JutomDev/MiCam/3d_print_files/front_multicolor_stl/Logo_M_bot.stl

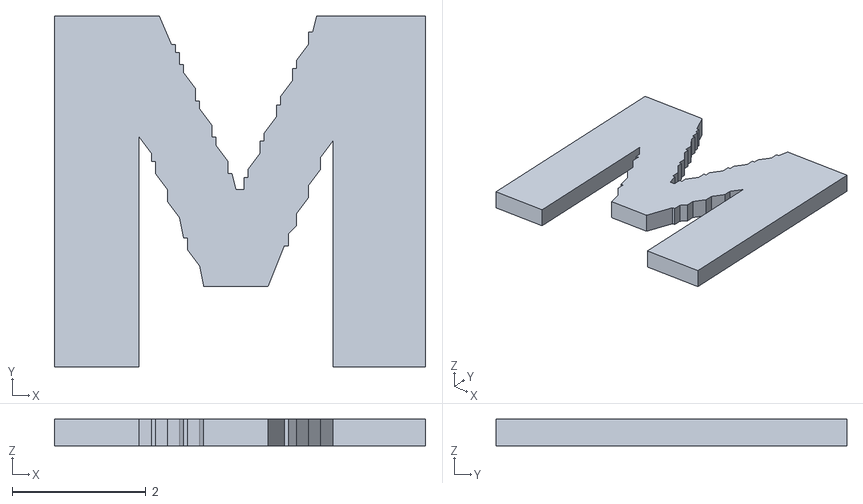
[picture p5: CAD file, 2026-10-22]
3d_print_files/front_multicolor_stl/Logo_M_bot.stl
5.54 x 5.24 x 0.4
