JutomDev/MiCam/3d_print_files/PART_Shell_Front_V8.step

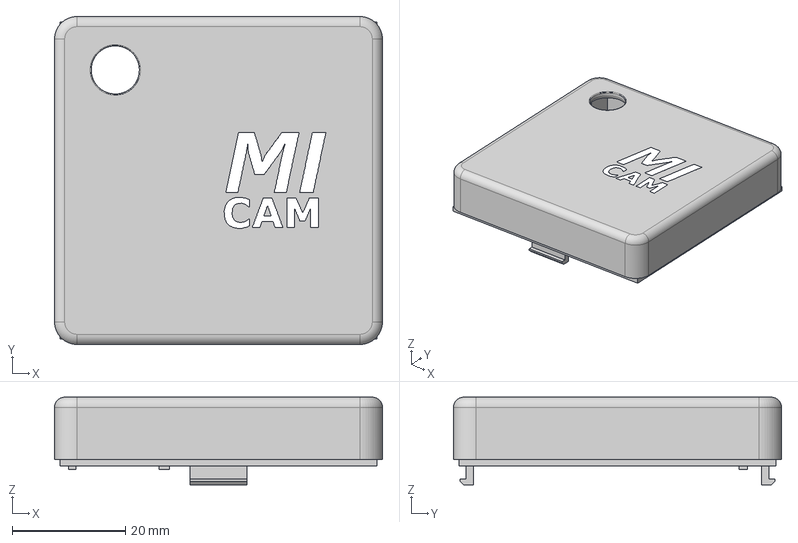
[picture p6: CAD file, 2026-10-22]
3d_print_files/PART_Shell_Front_V8.step
58.0 x 58.0 x 15.5 mm
