JutomDev/MiCam/3d_print_files/front_multicolor_stl/Logo_C_bot.stl

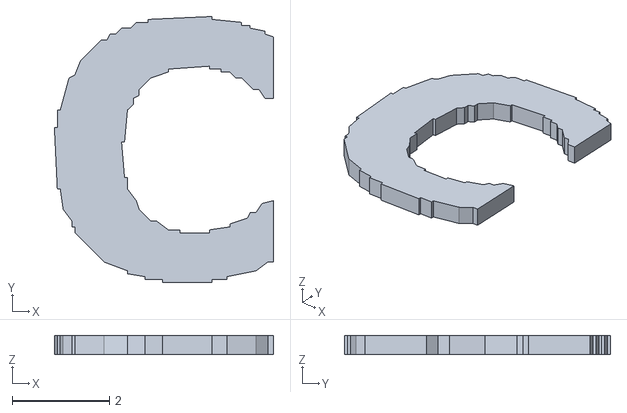
[picture p8: CAD file, 2026-10-22]
3d_print_files/front_multicolor_stl/Logo_C_bot.stl
4.51 x 5.48 x 0.4
