JutomDev/MiCam/3d_print_files/Shutter_Plunger_Button.stl

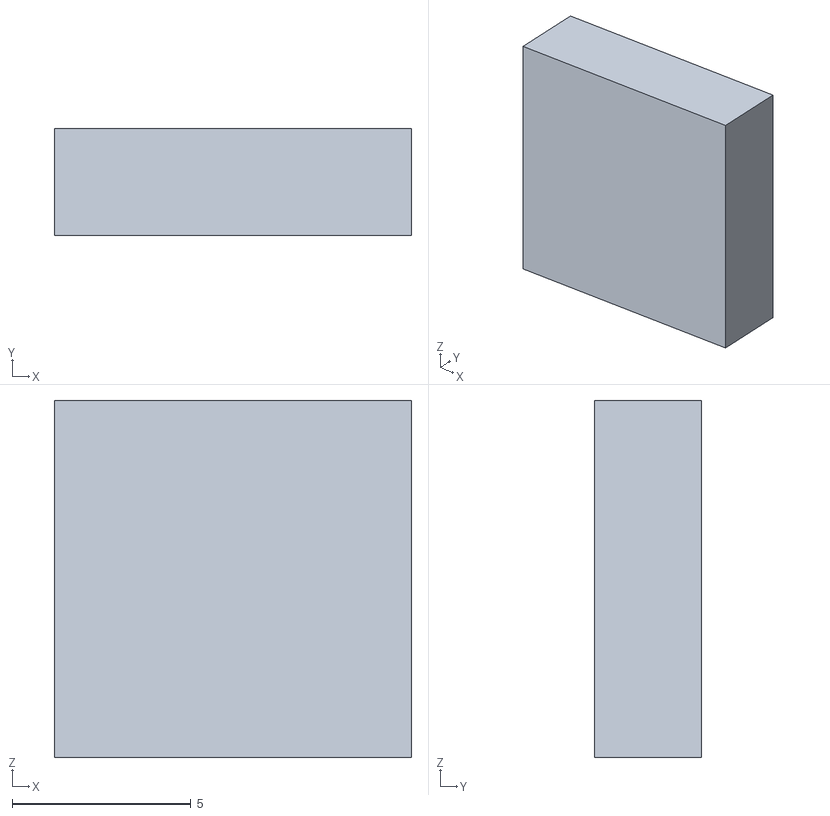
[picture p9: CAD file, 2026-10-22]
3d_print_files/Shutter_Plunger_Button.stl
10.0 x 3.00 x 10.0
