JutomDev/MiCam/cad_models/Waveshare_1.69_LCD_Module.step

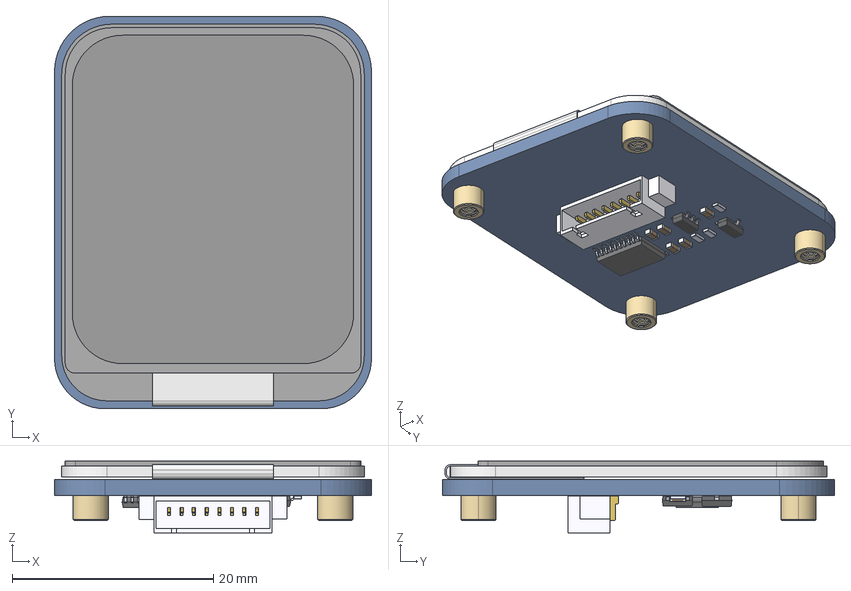
[picture p10: CAD file, 2026-10-22]
cad_models/Waveshare_1.69_LCD_Module.step
31.5 x 39.0 x 7.11 mm
1_69INCH-240X280-LCD
1_69INCH_LCD_MODULE-PCBA
STUDS-M2XH2_5 x 4
