JutomDev/MiCam/3d_print_files/front_multicolor_stl/Logo_A_bot.stl

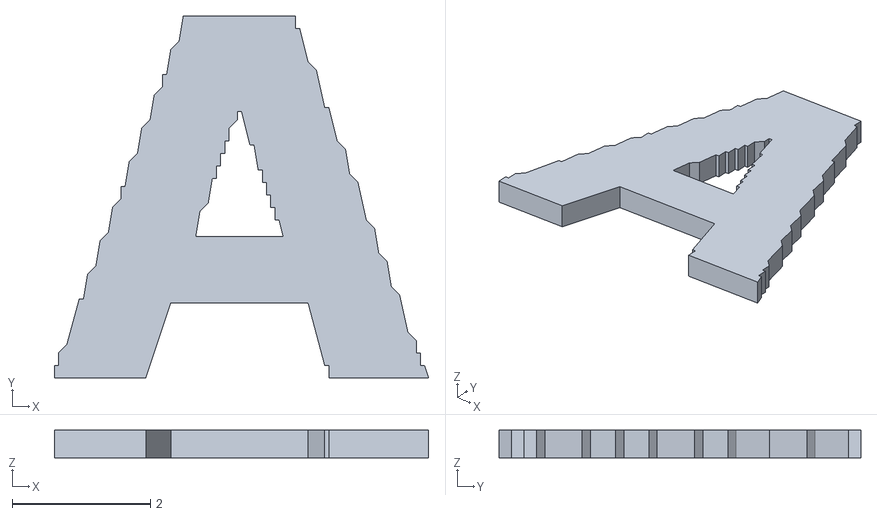
[picture p11: CAD file, 2026-10-22]
3d_print_files/front_multicolor_stl/Logo_A_bot.stl
5.42 x 5.24 x 0.4
