JutomDev/MiCam/3d_print_files/front_multicolor_stl/Logo_M_top.stl

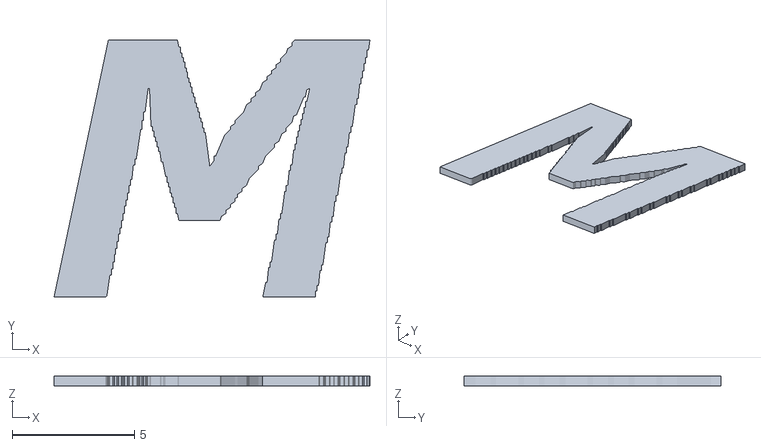
[picture p12: CAD file, 2026-10-22]
3d_print_files/front_multicolor_stl/Logo_M_top.stl
12.9 x 10.5 x 0.4
