JutomDev/MiCam/3d_print_files/PART_Shell_Rear_V8.step

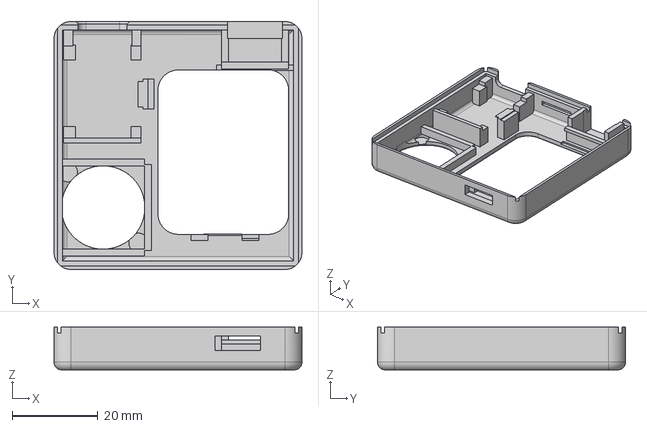
[picture p13: CAD file, 2026-10-22]
3d_print_files/PART_Shell_Rear_V8.step
58.0 x 58.0 x 10.0 mm
