JutomDev/MiCam/3d_print_files/front_multicolor_stl/Body_Shell_Front.stl

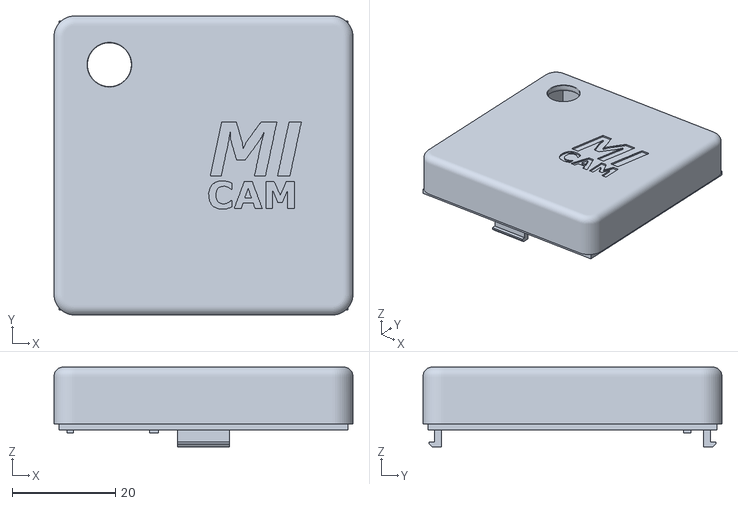
[picture p14: CAD file, 2026-10-22]
3d_print_files/front_multicolor_stl/Body_Shell_Front.stl
58.0 x 58.0 x 15.5
