JutomDev/MiCam/3d_print_files/front_multicolor_stl/Logo_I_top.stl

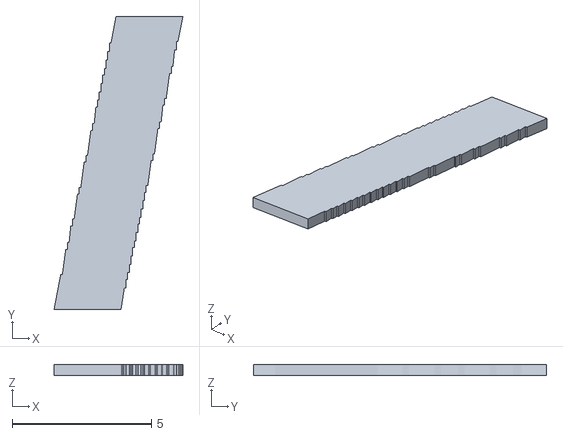
[picture p15: CAD file, 2026-10-22]
3d_print_files/front_multicolor_stl/Logo_I_top.stl
4.63 x 10.5 x 0.4
