JutomDev/MiCam/(list of files, cad)

Other CAD files:
3d_print_files/PART_Shell_Front_V8_Body.stl
3d_print_files/PART_Shell_Rear_V8.stl
