JutomDev/MiCam/include/wifi_share.h

#pragma once

#include <Arduino.h>
#include <WiFi.h>
#include <WebServer.h>
#include <DNSServer.h>
#include <ESPmDNS.h>
#include "config.h"

class WifiShare {
public:
    static bool start();
    static void stop();
    static void loop();
    static bool isRunning();
    static String getIP();

private:
    static WebServer _server;
    static DNSServer _dnsServer;
    static bool _running;
    static bool _eventsRegistered;

    static void handleRoot();
    static void handleGalleryPage();
    static void handleSnapshot();
    static void handleCapture();
    static void handlePreset();
    static void handleAudioLevel();
    static void handleToggleClap();
    static void handleToggleMute();
    static void handleAudioThreshold();
    static void handleAudioGain();
    static void handleDownload();
    static void handleView();
    static void handleDelete();
    static void handleDiag();
    static void handleCaptiveRedirect();
    static void handleNoContent();
    static void handleNotFound();
};
