JutomDev/MiCam/(commit log)

2026-10-22 feat: MIphoto - DIY retro compact camera (ESP32-S3 Sense + Fusion 360)
    [Body_Shell_Front.stl, Logo_A_bot.stl, Logo_C_bot.stl, Logo_I_top.stl, Logo_M_bot.stl, Logo_M_top.stl, PART_Shell_Front_V8.step, PART_Shell_Front_V8_Body.stl]
2026-11-13 fix: resolve SoftAP brownout reset, add speaker mute, update pinout and docs
    - Prevent Wi-Fi Brownout/WDT reset on phone connection (11 dBm TX power limit, chunked PROGMEM streaming, max 2 clients)
    - Eliminate FAT table scan in handleRoot and per-frame 128KB malloc churn via captureJpegStatic
    - Add hardware speaker mute option (default muted at boot) in menu and web UI
    - Align hardware pinout across firmware (D0 Shutter, D6 RST, D7 Buzzer, D4/D5 Joystick, D1-D3 ST7789)
    - Synchronize README.md, cad_models/README.md, and system guidelines with verified wiring
    [audio_mic.cpp, buzzer.cpp, buzzer.h, camera_driver.cpp, camera_driver.h, config.h, display_ui.cpp, display_ui.h]
